YahiaEid-1/stm32-can-telemetry-logger/results/Matlab_Plots/ReplayVsActual_images.png

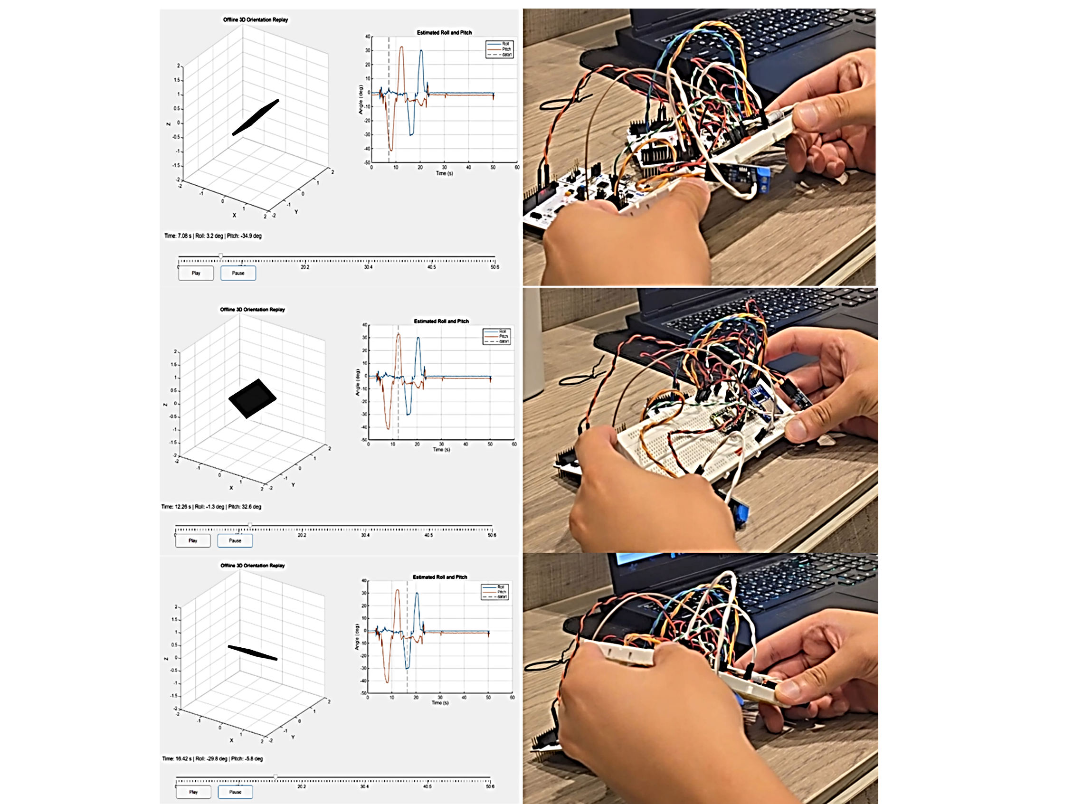
results/Matlab_Plots/ReplayVsActual_images.png
