YahiaEid-1/stm32-can-telemetry-logger/images/Logger_node.jpg

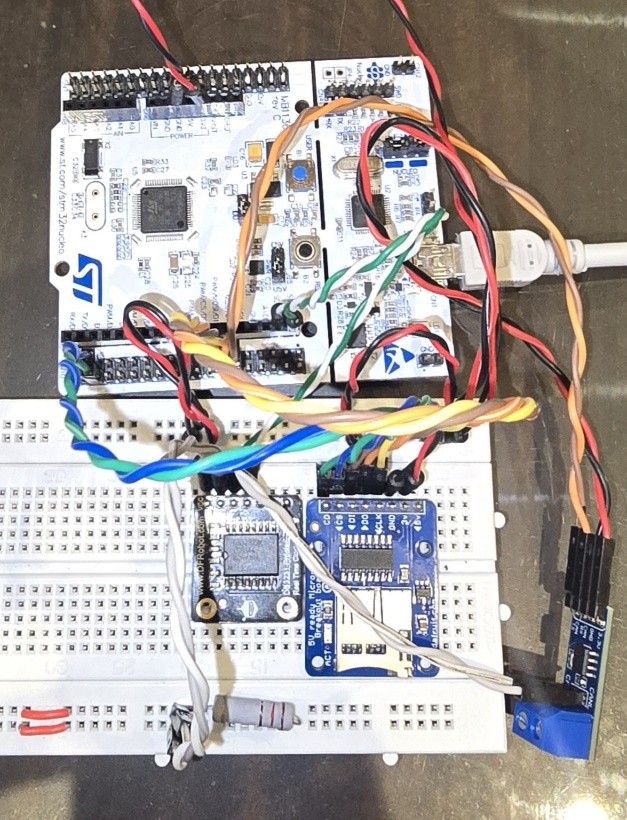
images/Logger_node.jpg
