YahiaEid-1/stm32-can-telemetry-logger/images/Full_Prototype.png

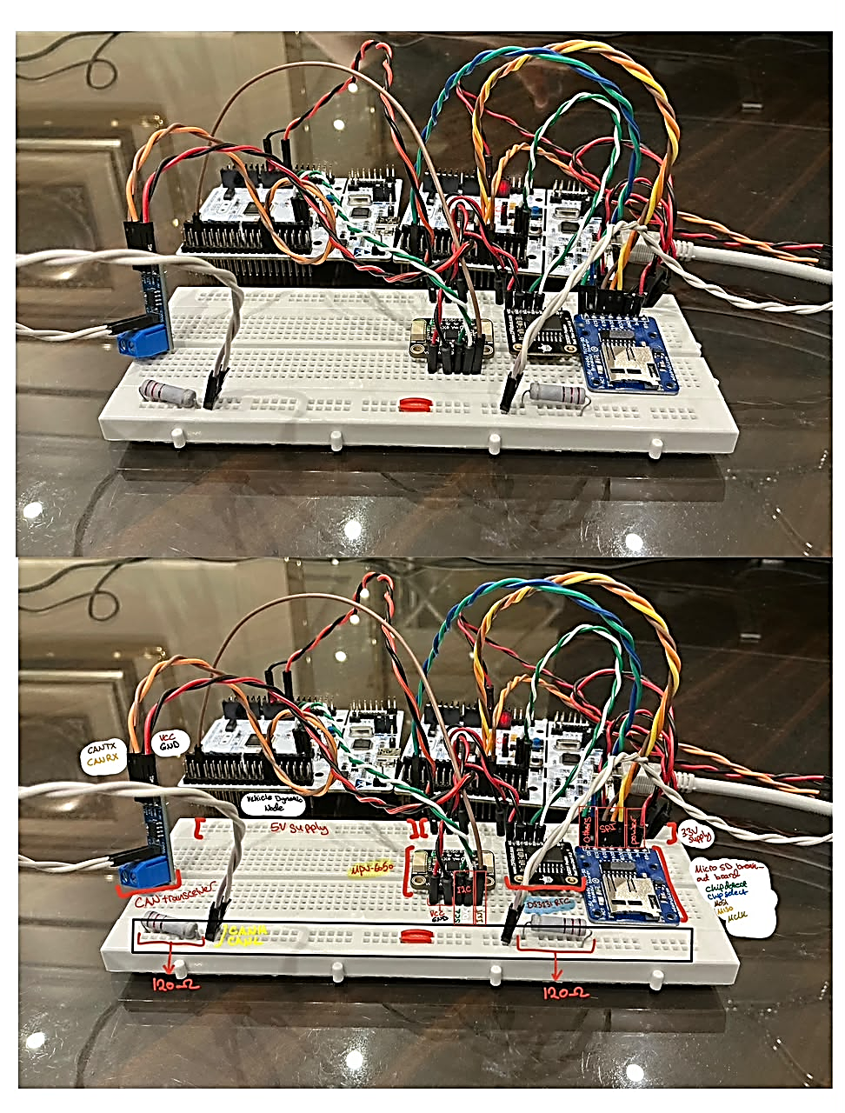
images/Full_Prototype.png
