YahiaEid-1/stm32-can-telemetry-logger/images/Vehicle_dynamics_node.jpg

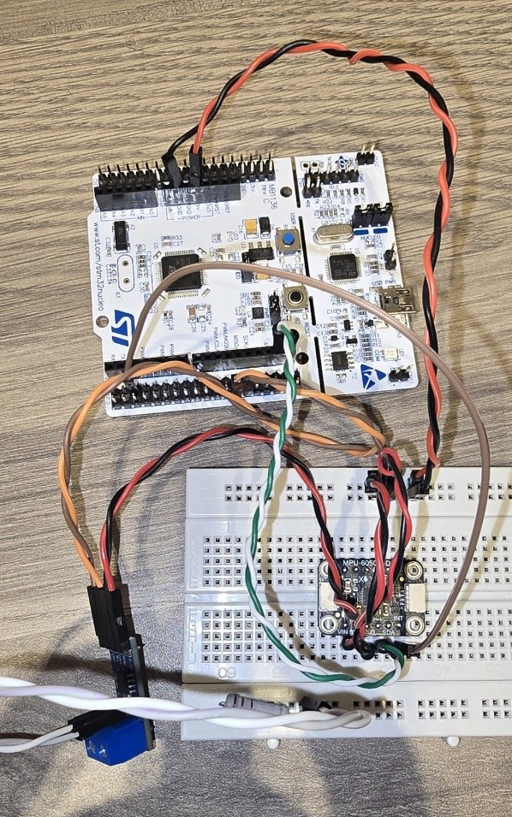
images/Vehicle_dynamics_node.jpg
