YahiaEid-1/stm32-can-telemetry-logger/results/50mins_readings/LOG.CSV

timestamp | time_ms | accel_x | accel_y | accel_z | gyro_x | gyro_y | gyro_z | status
2026-08-04 16:17:51 | 27669 | 108 | -50 | 3799 | -469 | -194 | 115 | OK
2026-08-04 16:17:51 | 27704 | 78 | -60 | 3780 | -288 | 494 | 142 | OK
2026-08-04 16:17:52 | 27907 | 77 | -50 | 3770 | -409 | 24 | 114 | OK
2026-08-04 16:17:52 | 27995 | 54 | -52 | 3763 | -398 | -52 | 114 | OK
2026-08-04 16:17:52 | 28093 | 43 | -47 | 3778 | -429 | -74 | 112 | OK
2026-08-04 16:17:52 | 28192 | 41 | -40 | 3784 | -444 | -31 | 118 | OK
2026-08-04 16:17:52 | 28290 | 33 | -47 | 3769 | -447 | -78 | 111 | OK
2026-08-04 16:17:52 | 28389 | 41 | -37 | 3763 | -461 | -178 | 119 | OK
2026-08-04 16:17:52 | 28487 | 33 | -45 | 3760 | -454 | -133 | 113 | OK
2026-08-04 16:17:52 | 28586 | 34 | -44 | 3752 | -462 | -182 | 110 | OK
2026-08-04 16:17:52 | 28723 | 27 | -62 | 3756 | -473 | -222 | 110 | OK
2026-08-04 16:17:53 | 28783 | 29 | -47 | 3761 | -530 | -427 | 111 | OK
2026-08-04 16:17:53 | 28881 | 97 | -57 | 3783 | -665 | -889 | 118 | OK
2026-08-04 16:17:53 | 28980 | 107 | -67 | 3777 | -476 | -257 | 134 | OK
2026-08-04 16:17:53 | 29078 | 114 | -64 | 3763 | -467 | -198 | 118 | OK
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
