YahiaEid-1/stm32-can-telemetry-logger/results/LOG.CSV

timestamp | time_ms | accel_x | accel_y | accel_z | gyro_x | gyro_y | gyro_z | status
2026-07-12 16:39:47 | 181 | 118 | -15 | 3771 | -457 | -186 | 103 | OK
2026-07-12 16:39:47 | 666 | 110 | -4 | 3762 | -446 | -190 | 100 | OK
2026-07-12 16:39:48 | 848 | 110 | -4 | 3752 | -445 | -191 | 105 | OK
2026-07-12 16:39:48 | 987 | 115 | -17 | 3783 | -447 | -190 | 92 | OK
2026-07-12 16:39:48 | 1127 | 120 | -10 | 3768 | -439 | -190 | 111 | OK
2026-07-12 16:39:48 | 1267 | 104 | -12 | 3773 | -441 | -194 | 89 | OK
2026-07-12 16:39:48 | 1406 | 114 | -12 | 3773 | -439 | -187 | 107 | OK
2026-07-12 16:39:48 | 1546 | 110 | -21 | 3752 | -441 | -183 | 97 | OK
2026-07-12 16:39:48 | 1685 | 111 | -6 | 3782 | -448 | -114 | 94 | OK
2026-07-12 16:39:49 | 1868 | 99 | 0 | 3766 | -437 | -179 | 96 | OK
2026-07-12 16:39:49 | 2007 | 115 | -4 | 3763 | -454 | -198 | 87 | OK
2026-07-12 16:39:49 | 2146 | 105 | -3 | 3773 | -434 | -185 | 103 | OK
2026-07-12 16:39:49 | 2286 | 113 | -2 | 3774 | -445 | -186 | 96 | OK
2026-07-12 16:39:49 | 2425 | 110 | 8 | 3762 | -441 | -192 | 104 | OK
2026-07-12 16:39:49 | 2564 | 72 | -23 | 3752 | -427 | -193 | 107 | OK
2026-07-12 16:39:49 | 2704 | 96 | -14 | 3761 | -455 | -347 | 760 | OK
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
