YahiaEid-1/stm32-can-telemetry-logger/results/50mins_readings/Count.png

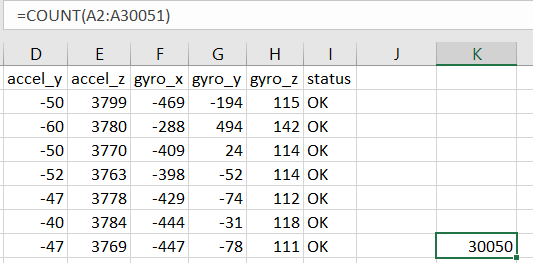
results/50mins_readings/Count.png
