YahiaEid-1/stm32-can-telemetry-logger/results/Matlab_Plots/Accelerometer_plot.jpg

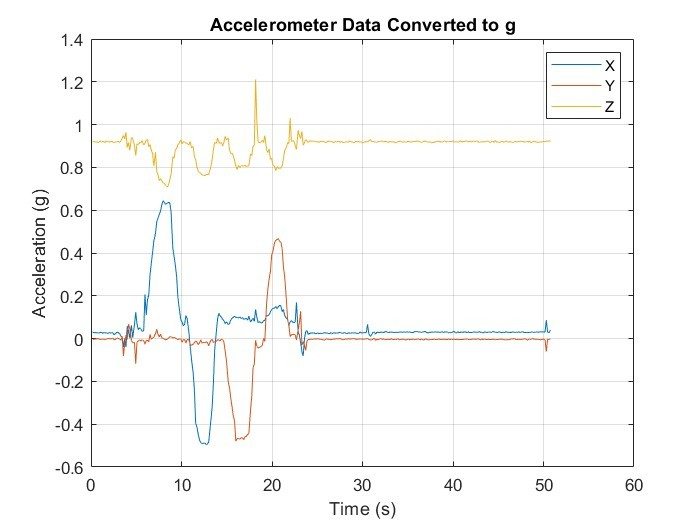
results/Matlab_Plots/Accelerometer_plot.jpg
