YahiaEid-1/stm32-can-telemetry-logger/results/Matlab_Plots/Roll&Pitch_plot.png

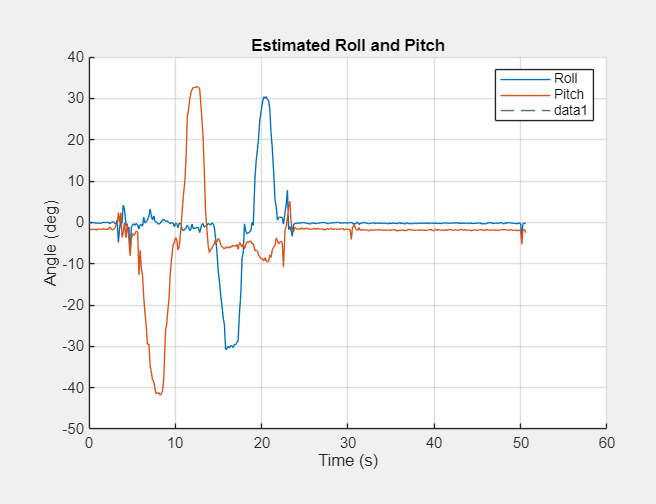
results/Matlab_Plots/Roll&Pitch_plot.png
