YahiaEid-1/stm32-can-telemetry-logger/results/Uart_Outputs/CAN_LoopBackMode_Result.png

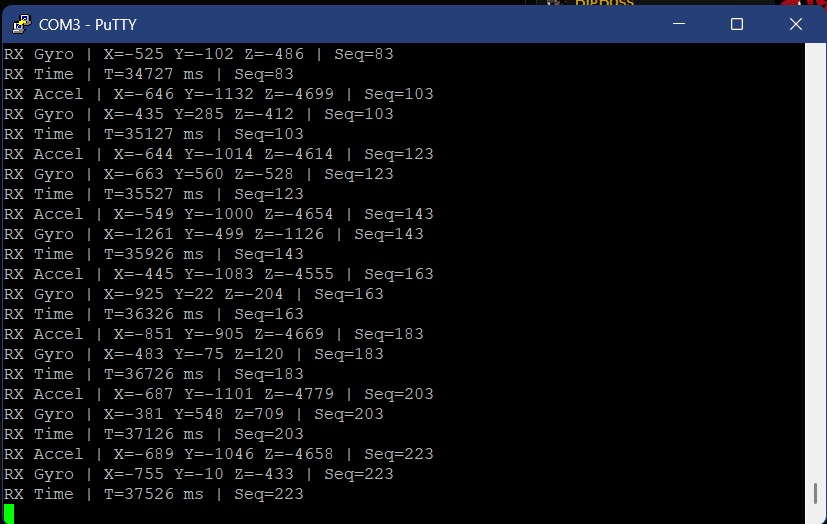
results/Uart_Outputs/CAN_LoopBackMode_Result.png
