YahiaEid-1/stm32-can-telemetry-logger/results/Uart_Outputs/MicroSD_LogRowWrite_Result.png

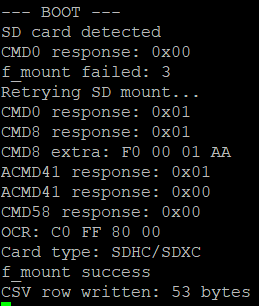
results/Uart_Outputs/MicroSD_LogRowWrite_Result.png
