YahiaEid-1/stm32-can-telemetry-logger/results/Uart_Outputs/MicroSD_MountTest_Result.png

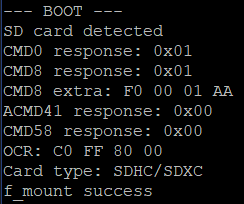
results/Uart_Outputs/MicroSD_MountTest_Result.png
