YahiaEid-1/stm32-can-telemetry-logger/results/Uart_Outputs/MPU-6050_SelfTest_Result.jpg

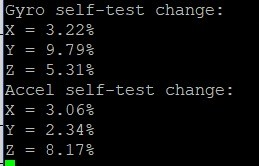
results/Uart_Outputs/MPU-6050_SelfTest_Result.jpg
