YahiaEid-1/stm32-can-telemetry-logger/results/Uart_Outputs/RTC-DS3231_Test_Result.png

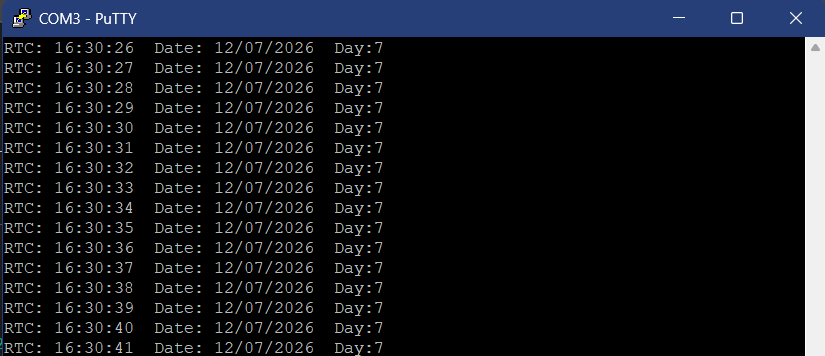
results/Uart_Outputs/RTC-DS3231_Test_Result.png
