YahiaEid-1/stm32-can-telemetry-logger/firmware/Logger_Node/Logger_Node.ioc

Mcu.UserName=STM32F446RETx
PA10.GPIO_Label=SD_CS
PA10.Signal=GPIO_Output
PA11.Signal=CAN1_RX
PA12.Signal=CAN1_TX
PA2.Signal=USART2_TX
PA3.Signal=USART2_RX
PA5.Signal=SPI1_SCK
PA6.Signal=SPI1_MISO
PA7.Signal=SPI1_MOSI
PB8.Signal=I2C1_SCL
PB9.Signal=I2C1_SDA
PC4.GPIO_Label=SD_CD
PC4.Signal=GPXTI4
