YahiaEid-1/stm32-can-telemetry-logger/firmware/Logger_Node/Core/Inc/main.h

#define SD_CD_Pin GPIO_PIN_4
#define SD_CD_GPIO_Port GPIOC
#define SD_CS_Pin GPIO_PIN_10
#define SD_CS_GPIO_Port GPIOA
