YahiaEid-1/stm32-can-telemetry-logger/(notices)

Notices in the files:
firmware/Vehicle_Dynamics_Node/Core/Src/main.c:
Copyright (c) 2026 STMicroelectronics.
All rights reserved.
This software is licensed under terms that can be found in the LICENSE file
